ALTAIR-McGill-x-UVictoria/Altair-Photodiode-Readout/README.md

# Altair-Photodiode-Readout
Precision readout electronics for the integrating sphere photodiodes. Contains PCBs, RF shields, Carrier boards, and basic drive software.
