ALTAIR-McGill-x-UVictoria/Altair-Photodiode-Readout/Squad_V26.5a/Sergeant_SchematicV26.4a.pdf

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
Title

Size | Number | Revision
Tabloid
Date: | 5-27-2026 | Sheet of
File: | C:\Users\..\top.SchDoc | Drawn By: V26C (V26.4a)

VBAT

NEG_SW

PWR1
Power.SchDoc

VBAT

SPI_CS_BV
SPI_SCLK
SPI_MOSI
SPI_MISO
SPI_CS_ADC

ADC_CLK
ADC_DRDY
ADC_STRT
ADC_RESET

INT_HLD
INT_RST

INT_SLCT_A
INT_SLCT_B

IVC_SW_1
IVC_SW_2

BIO1
BoardInterfaces.SchDoc

A5VSW -11V

IVC_SW_IN

ACF_SWA_IN

TIA_OUT

SPI_SCLK
SPI_MOSI

SPI_CS_BV

BRD_TMP
PD_TMP

GUARD

GAIN_SW

IVC_SW

ACF_SW

TIA_SW

TIA1
TIA.SchDoc

ACF_IN_SGT

IVC_IN_SGT

GUARD

IVC_SW1
IVC_SW2

IVC_OUT

ACF_OUT

ACF_HOLD
ACF_RESET

ACF_SELB

ACF_SELA

INT1
Integrators.SchDoc

GUARD

PD_TMP

BRD_TMP

TIA_OUT

SPI_CS_ADC

STRT

ACF_OUT
IVC_OUT

SPI_MOSI

SPI_SCLK

SPI_MISO

DRDY

RESET

ADC_CLK

NEG_SW

GAIN_SW

IVC_SW

ACF_SW

TIA_SW

ADC1
ADC.SchDoc

3V3

1 6

### ALTAIR Photodiode Acquisition Payload - Sergeant

(Based on UVic ORCASat design Rev A.6 by Evan Moore)

4V9

10V

Nicholas Sandor

A2V5 AVDD

BIO1 contains most (but not all) interfaces between this board and others:
Main system header, power header, board-stacking headers, mounting holes. Most other sheets contain some other parts of the interface.

PWR1 turns the input power into the needed power nets: +10V, switch-specific +5V, ADC AVDD (its own +5V), -11V for the integrators, +4.9V virtual ground, +2.5V for the integrator output shifting and ADC reference.

TIA1 handles both ends of the photodiode (reverse bias setting and switching on the cathode, photocurrent on the anode).

It also contains a transimpedance amplifier for directly measuring the current in the case where the laser is not pulsed, a relay switch to change the gain on that TIA, and relay switches to instead send the photocurrent to the integrators for time-averaged photocurrent measurements.

It also contains temperature monitors for both the board (specifically near the TIA) and the photodiode mounting location.

We need to measure the
extremely small
photodiode current as
precisely as possible, so
the traces that carry it are very sensitive to noise
from many sources. To
help accomplish this,
those traces are
surrounded by guards,
shown in these schematics
as cyan wires and lines.

INT1 contains two integrator circuits.

One works with the ACF2101 dual-channel switched integrator, which is the primary measurement device for photocurrents from both the Sergeant board and the stacked Soldier board, connected through spring-loaded pogo pins and pads.

The other works with the IVC102 single-channel switched integrator, which serves to validate the values given by the ACF2101. The Soldier board has its own IVC102 as well.

ADC1 contains the analog-to-digital converter, some inverting amplifiers that scale down, shift, and negate the integrator outputs to a range the
ADC can read, and a clock generator circuit for externally clocking the ADC.

The A2V5 power net is taken from the ADC's internal voltage reference.

# THIS REVISION, V26_, WAS SENT FOR FABRICATION ON

____.

# Compatible board: Soldier: ______

Changes from V26B include:
- Added TIA isolation relays and associated control lines to prevent amplifier contention
- Add 2:4 Decoder to allow for one extra IO relay control and enforce amplifier mutual exclusivity
- Rework power-on sequencing to ensure that ADC AVDD is on before input voltages on its lines rise above allowable thresholds
- Add input anti-aliasing filters for all critical inputs (also provides over/undervoltage protection)
- Fix thermistors lacking any bias
- Updated soldier to bring it in-line with V26B baseline
- Various little fixes
- Fix fast-start for 10V
- 5V adjustment resistors removed (fixed voltage model)
- Drop TIA max voltage from 10V to 5V to prevent overvoltage events in case of negative photocurrent

D D

C C

B B

A A

Title

File: | C:\Users\..\BoardInterfaces.SchDoc | Drawn By:

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
440054-4

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
10 10
11 11
12 12
13 13
14 14
15 15
16 16
17 17
18 18
19 19
20 20

MP1 MP1
MP2 MP2
MP3 MP3
MP4 MP4
MP5 MP5

J1

DF19-20P-1V_52_

01 01
03 03
05 05
07 07
09 09
11 11
13 13
15 15
17 17
19 19

02 02
04 04
06 06
08 08
10 10
12 12
14 14
16 16
18 18
20 20

J2

CLP-110-02-X-D

01 01

03 03

05 05

07 07

09 09

11 11

13 13

15 15

17 17

19 19

02 02

04 04

06 06

08 08

10 10

12 12

14 14

16 16

18 18

20 20

J3

CLP-110-02-X-D

SYS_VBAT
SYS_GND
SYS_DVDD
DIG_GND

INT_SLCTA
SYS_RESET
INT_RST
INT_HLD
INT_SLCTB
DRDY1
DRDY2
SPI_MOSI
STRT1
STRT2
SPI_MISO
SPI_CS3
SPI_CS4
SPI_SCLK
SPI_CS1
SPI_CS2
IVC_SW_1_Sol
IVC_SW_2_Sol
IVC_SW_1
IVC_SW_2

GND

SYS_GND
DIG_GND
DRDY1
DRDY2
SPI_MOSI
STRT1
STRT2
SPI_CS3
SPI_CS4
SYS_GND

SYS_VBAT
SYS_RESET
SYS_DVDD
ADC_CLK
SPI_MISO
SPI_SCLK
SPI_CS1
SPI_CS2
IVC_SW_1_Sol
IVC_SW_2_Sol

SYS_GND

DIG_GND

DRDY2
DRDY1

SPI_MOSI

STRT2
STRT1

SPI_CS4
SPI_CS3
SYS_GND | IVC_SW_2_Sol IVC_SW_1_Sol SPI_CS2 SPI_CS1 SPI_SCLK SPI_MISO ADC_CLK SYS_DVDD SYS_RESET SYS_VBAT

VBAT
top[5B], Power[1B]

3V3

GND

INT_SLCT_B top[5B]

R2
47R

R1

10k

3V3

ADC_RESET | top[5B]
INT_RST | top[5B]
INT_HLD | top[5B]
ADC_DRDY | top[5B]

SPI_MOSI top[5B], ADC[5B], TIA[1D]

INT_SLCT_A | top[5B]
ADC_STRT | top[5B]

SPI_MISO top[5B], ADC[5B]

R4
0R OPT

R3
0R OPT

R7
TBD OPT

R6
TBD OPT
R10 | SPI_CS_BV | top[5B], TIA[1D]

TBD OPT

R9
TBD OPT

R5
47R

SPI_SCLK top[5B], ADC[5B], TIA[1D]

R11
47R
R13 | SPI_CS_ADC top[5B], ADC[5B]

TBD OPT

R12
TBD OPT

IVC_SW_1 top[5B]
IVC_SW_2 top[5B]

ADC_CLK
top[5B], ADC[5B]
H1 H2 H3 H4

GND

R8

0R DNP

GND

2 6

### ALTAIR Photodiode Acquisition Payload - Sergeant

R99

0R
GND

Nicholas Sandor ² ¹ D4

SMAJ12A

GND

1 | 2 | VBAT

F1

0ZCG0030FF2C

JP Power Header,
4x1 THT Partially Shrouded

J2 : Top Board-Stacking Header; 10x2 SMD (female)

Placed and aligned directly above

J3 : Bottom Board-Stacking Header; 10x2 SMD (female)

In practice the top header exists primarily to facilitate debugging and the bottom header connects to a male FTSH-110-F-DV header on the Soldier board.

Previously, the Specialist board was also part of the stack, but the tall relays make this impractical.

J1 : System header; 20x1 Vertical SMD

Populate only ONE of R3 (!DRDY1) or R4 (!DRDY2). Channel numbers must match.

Populate only ONE of R6 (STRT1) or R7 (STRT2).
Exception: Can populate both if simultaneous non-SPI external triggering is desired. Channel numbers must match.
Can use nonzero resistance for damping the signal as desired.

Populate R8 if configuring ADC conversion through SPI commands instead.

Populate only ONE of R9 (!CS3) or R10 (!CS4).
Channel numbers must match.
Can use nonzero resistance for damping the signal as desired.

Populate only ONE of R12 (!CS1) or R13 (!CS2). Channel numbers must match.
Can use nonzero resistance for damping the signal as desired.

Board Mounting Holes (M3)

Digital ground used to only connect to analog ground after passing through a pin of the IVC102 integrator, to shield the sensitive side of the chip from digital noise. That shielding is now done with the virtual ground net, and R99 connects digital ground to analog ground close to the power header.

F1 polyfuse and D4 TVS diode protect the board from incorrect power supply characteristics or connections.

Rated for up to 14V and 300mA.

D D

C C

B B

A A

Title

File: | C:\Users\..\Power.SchDoc | Drawn By:

IN 1
IN 2
IN 3
EN/UV 4
PG 5
ILIM 6
PGFB | 7
SET | 8
GND | 9
OUTS | 10
OUT | 11
OUT | 12 GND 13

U3

LT3045

EN/UV 3

ILIM 6

IN 1
IN 2
IN 13

PG 4

VIOC 7

GND | 9
OUT | 12
OUT | 11
OUTS | 10
PGFB | 5
SET | 8

U8

LT3094EDD#PBF

VIN 1

EN 3

VOUT | 5
GND | 2
SENSE/ADJ | 4

U4

ADP7142AUJZ-5.0-R7

VBAT

top[5C], BoardInterfaces[3A]

R14
0R

GND

GND | GND

C3
10uF

R15
100k

GND

C2
10uF

C1
10uF

GND

R17
10k

R16
300k

GND

C4
10uF

GND

R18
680R

D2
BLUE

GND

10V

SW | 1
NFB | 3
SHDN 4
GND 2

VIN 5

U7

LM2611AMF/NOPB

C14
10uF

GND

L1

10uH

C15

1uF

R29
30k

C16
330pF 2 1
D1
MBR0520
GND | GND

L2

10uH

C18
10uF

GND

GND

C19
10uF

GND

R30
1k

-16V

R31
1.5k

C17
1uF DNP

GND

TP1

-16V

R32
110k

C21
4.7uF

GND GND

C20
10uF

GND

TP5 -11V

GND

TP2

GND
C9
1uF
TP3

C10
0.1uF

A5VSW

R21 10k

R22
10k

3 6

### ALTAIR Photodiode Acquisition Payload - Sergeant

TP4

R23

2.32k R24 2.23k

4V9

C11
0.1uF

C12
10uF

C13
0.1uF

1
2

JLED

OUT A 1
-IN A 2
+IN A 3
V- 4 | +IN B 5

-IN B 6

OUT B 7

V+ 8

U5

OPA2182

GND | GND

10V

10V

GND

C1 1

C2 3 B¹

## 2 B2

5

E2 4

E1 6

U6
ZXTC2045E6

GND

10V

R25 47R

R26 47R

R28 0.1R

R27 0.1R

GND

10V

GND

C58
2.2uF

GND

C59
2.2uF

R34
100k

R19

47R

GND

C5
0.1uF | C24
| 0.1uF

C6
10uF | C8
| 10uF

DNC 1

VIN 2

TEMP 3
GND 4
TRIM/NR | 5
VOUT | 6
NC | 7
DNC | 8

U10

REF5025

C7
10uF
GND | GND
10V | A2V5 TP10

R35
100k

R20

47R

NEG_SW

top[5C], ADC[4B]

GND

AVDD

+10.0V, up to 500mA (or lower current limit if set)

U3 SET pin sets output voltage:
V = R15 * (100uA)

Larger capacitance in parallel reduces output ripple level.

If different board voltage level is desired, adjust value of R15 as necessary according to the above equation.

For 500mA current limit: Use 0-Ohm jumper for R14 .

Otherwise, current limit is
I(lim) = (150 mA-kOhm) / R

Decide on a current and set R14 to the found value of R.

U3 PGFB pin:
Power Good functionality is not used (see No-ERC on PG).

The R16 R17 divider is for fast start-up functionality, to speed up the regulator's transient response despite C3 on the SET pin otherwise slowing it down.

As long as the output voltage is lower than the set threshold, there is 2mA instead of 100uA through SET pin. That threshold is
V(PG) = (0.3V)(1 + R16/R17) - I(PGFB) R56

Where I(PGFB) is on the order of 1E-8 A.

1.4MHz Cuk converter to generate a negative supply. Consider soft start?

Negative voltage regulator set to -11V for the integrators.

(Current needed from this net is on the order of 20mA, far below the 500mA limit of the regulator.)

AVDD pin of ADC requires
significant decoupling capacitance to supply current during sampling process.

5V ±1%, 200mA supply for ADC AVDD.

Gain switches (and digital isolators for virtually grounded component controls) are powered from a separate 5V reference, to keep noisy transients from switching the relays off of the sensitive rails.

The switches' 5V rail does not need to be very precise, and we want to remove dependency on ADC AVDD to keep that line more flexible.

This is a very simple divider using 0603 resistors that will get us close enough to 5V, or 1/2 of 10V.

The divider itself will dissipate about 5mW. If this is too much the resistances can be increased to some extent.

Steady state is when V(NFB) = -1.23V. Thus output voltage is
Vout = (-1.23V)(1 + R29/(R30 + R31))

This is the source of the virtual ground used by the bias control circuit, TIA, and integrators. It is specified as 4.9V to prevent a leakage current at the TIA input from saturating the ADC.

More accurately, the target voltage is 10V(2.23/(2.23+2.32)) = 4.9010989V +/- 0.2% (approx. tolerance)

U6 OPA2182 is a 2-channel, zero-drift op-amp used to buffer the relay supply voltage and the virtual ground. It can source or sink up to 65mA, but it may exhibit ringing or unstable transient responses with a load capacitance of up to 1nF.

Since the OPA(2)182 is a zero-drift op-amp, it has an internal switching mechanism that runs at about 200kHz. While this is usually strongly attenuated, the emitter-follower may amplify it somewhat. However, 200kHz is far outside the bandwidth at which the ADC can perform measurements even on its fastest sample rate.

The virtual ground has some fairly steep requirements that we must meet. Any noise in the virtual ground couples directly into TIA readings and every stage of the integration process for the integrators, so the node must be low-noise. It must also be able to sink significant current from the power-hungry integrators, and it must support significant load capacitance from bypass capacitors on digital isolators, bias control ICs, and intgrators.

To address this, a complementary emitter-follower output stage is added to the OPA182 output to source and sink current and to isolate the capacitance from the op-amp's output drive.

Most simpler solutions are either too noisy, too unstable with capacitances above a few picofarads, or have too little current capacity.

Power draw from R23/R24 divider:

P = V^2/R = 100/4550 = 21mW.

Quite high. Self heating concern?

Note that you cannot go TOO high on these resistors, or the VGN will take too long to rise, risking all 5V components referenced to it.

AVDD is now first to power on, to prevent power supply sequencing issues from overvolting the ADC inputs on startup. We use AVDD as the enable for the 10V line. Adjustment resistors were removed as this is the fixed voltage model so adjustment is not possible in any case.

Input/output capacitors are now reccomended 2.2uF.

Fast start up was still set to 6.3V, vestige from when this was a 7.5V supply probably. But as a result this takes multiple seconds to reach 10V.

Switching R16 to 300k gives a fast start threshold of 9.3V, which is better.

The negative voltage is
disabled by default. It should not be enabled until the ADC has powered up and confirmed that 2.5V exists across
REFP0/REFN0.

(e.g., enable and check
FL_REF_L1, then use the
external reference to measure (AVDD-AVSS)/4 as approx.
0x400000)

2.5V ±0.05%, 20mA supply for ADC reference and LT1991 common-mode voltage.

V26A tried to use the ADC's internal 2.5V reference instead of this part. That does not work because the internal reference is disabled by default, and if it is not enabled before the negative voltage is, the ADC sees dangerously negative voltages on analog inputs.

D D

C C

B B

A A

Title

File: | C:\Users\..\TIA.SchDoc | Drawn By:

4

K5
118-A-5/2D

1

2

3

### 4 K6

118-A-5/2D

1
2
3
4

K1
118-A-5/2D

1

2

3

### 4 K2

118-A-5/2D

1
2
3
4

K3
118-A-5/2D

1

2

3

### 4 K4

118-A-5/2D

A5VSW

ACF_SWA_IN

top[3C]

J10

1 2 3 Q1

GND

R37
100k

R36

47R

ACF_SW

top[4C], ADC[3B]

J11

1 2 3 Q2

GND

R40
100k

R39

47R

IVC_SW

top[4C], ADC[3B]

A5VSW

IVC_SW_IN

top[3C]

GUARD ACF INTEGRATOR INPUT

GUARD IVC INTEGRATOR INPUT

J12

1 2 3 Q3

GND

R43
100k

R42

47R

GAIN_SW
top[4C], ADC[4B]

A5VSW

C31
300pF

R46

10k

IN+ 1

GRD_1 2
DNC 3
V- 4

IN- 8
GRD_2 7
OUT 6

V+ 5

U13

OPA928DR

R45
1Meg

C30
10pF

(Same guard net)

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
60312002114503

1
2
3
4
5 6

J6
USB-miniB K

A

C28
1uF

C29
0.1uF

GND

TIA_OUT

top[3C], ADC[2B]

GND

10V

C22
0.1uF

C23
10uF

TP6

SPI_SCLK

top[4C], ADC[5B], BoardInterfaces[4B]

SPI_MOSI

top[4C], ADC[5B], BoardInterfaces[4B]

SPI_CS_BV

top[4C], BoardInterfaces[4B]

PD_K
PD_A

GUARD

GND

D

1

SA 2
GND | 3
VDD | 4
NC | 5

IN 6

VSS 7

SB 8

U11

ADG1419BRMZ-REEL7

C25
1uF

C00
TBD OPT

C0
TBD OPT

R0
TBD

10V

J5

R33
100k

TP7

NT 10K

RT1 C32
0.1uF

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
BC020-03-A-0200-0300-L-G

R49

0R OPT
R50
0R OPT

BRD_TMP
top[3C], ADC[4B]

R47

0R OPT

R48
0R OPT

PD_TMP
top[3C], ADC[4B]

TMP_COM
TMP_COM

# TEMPERATURE MONITORING

# PHOTODIODE INPUT/OUTPUT

# OPTIONAL RC FILTER

# BIAS SWITCHING

# BIAS VOLTAGE CONFIGURATION

# AMPLIFIER SWITCHING

# GAIN SWITCHING

# TRANSIMPEDANCE AMPLIFIER

GUARD top[3C], Integrators[4B]

10V

VBIAS

SYNC 1
SCLK 2
DIN 3

VOUT 6
GND 5

AVDD 4

U9

DAC5311

1 2

D3

MMSZ4679 DNP

4 6

### ALTAIR Photodiode Acquisition Payload - Sergeant

4V9

4V9

4V9

4V9

4V9

10V

GND | 4V9

4V9

4V9

4V9

4V9

A5VSW

VCC1 1

GND1 8

INA 2
INB 3
INC 4
IND 5
INE 6
INF 7
VCC2 | 16
GND2 | 9
OUTF | 10
OUTE | 11
OUTD | 12
OUTC | 13
OUTB | 14
OUTA | 15

U12

ISO7760DBQR

C27
0.1uF

C26
0.1uF
GND | 4V9

# DIGITAL SIGNAL ISOLATION

J15

1 2 3 Q4

GND

R41
100k

R38

47R

1
2
3
4

K7
118-A-5/2D

1

2

3

### 4 K8

118-A-5/2D

A5VSW

TIA_SW

top[4C], ADC[3B]

R51
10k

R44
10k

AVDD

AVDD

AVDD

The relays are paired and
wired in series (such that the
switch terminals are all Pin 3)
for extremely low EMF

Pickering 118-A-5/2D reed relays are used for much lower leakage current than solid-state switches while taking very little board space for relays.

Relay coil resistance (i.e., between A5VSW and MOSFET drains) is 2.2k per relay (1.1k per pair).

K1 and K2 allow photocurrent to reach the sergeant channel of the ACF integrator, which can give time-averaged photocurrent measurements for both the sergeant and the soldier photodiodes with nearly identical characteristics between the two.

K3 and K4 allow
photocurrent to reach the
IVC integrator, which
serves to validate the value read from the sergeant
channel of the ACF.

K5 and K6 add an impedance in parallel to R45 and C30 to lower the gain of the TIA, which measures the photocurrent in the case where the laser is not being pulsed.

NOTE: Feedback resistors must have EXTREMELY low thermal drift.

Capacitors should have C0G/NP0 rating.

Selected CF values are optimized for maximum stable bandwidth with the OPA928 (GBW=2.5MHz) driving the high input capacitance of the photodiode.

Here, we expect the anode to be at 4.9V and the cathode to be somewhere between 4.9V and the maximum reverse-bias voltage.

Place caps as close to the V+ terminal of the amp as possible

DAC U9 sets SPI-controlled bias voltage for photodiode reverse-bias operation. Nominal 2.5V output. Current limit 10mA.

AD5601 is a drop-in replacement for DAC5311 with slightly worse noise and linearity but identical pinout and interface. DAC5311 is preferred if available.

If used, place RC
filter as close as
possible to the
photodiode anode.

Otherwise, DNP the
capacitors and set
R0 = 0 Ohms.

Analog signals are limited to VDD + 0.3V, so VDD
must be at least higher
than the maximum reverse
bias generator output.

When J5 is jumped, the reverse bias generated from U9 is disabled. The same effect can be achieved by writing 0b01 to the most significant bits of the DAC5311's SPI shift register to set it in 1k power-down mode.

Calculation for the TIA stability capacitor:

Feedback resistor value: R [Ohms] (Calculated above) Bandwidth of circuit: f [Hz]

C = 1/(2pi R f) [F]

Board Temp Monitor
- Placed near TIA

Thermistor Local/Remote
Acquisition Jumpers:
Populate only one jumper in each of the indicated pairs to use on-board or off-board
ADC (not both).

The TIA is powered in
single-supply mode. This
complicates the use of the integrators.

In short, the TIA and the
integrators must be at or near the same common-mode voltage.
Furthermore, the integrators internally connect their
common-mode voltage to what they perceive as ground. Previous revisions violated that by having the TIA at 4.9V and the
integrators at 0V. Now, the integrators are moved up to treat 4.9V as a virtual ground.

This is expected to have
significantly less noise in the TIA signal compared to a dual-supply TIA.

D3 Photodiode protection Zener diode. Should only be placed if software cannot be trusted to operate the DAC safely. In that case, it should be populated with a Zener that will break down before the photodiode does, and paired with a current-limiting resistance in the RC filter. Most Zeners will have microamp scale leakage current. This acts as an additional source of shot noise that adds together with that from the photodiode dark current and limits measurement precision.

Per the AD5601 datasheet,
C23 should be a tantalum
capacitor. It is currently specified as an MLCC.

Removed the bias voltage output to the ADC. Measuring the bias voltage would require an additional step to scale it down or subtract virtual ground from it and avoid damaging the ADC, as it can go up to 10V.

U12 is a 6-channel digital isolator. This is necessary to propagate
the DAC SPI and bias switch control to the virtual-ground components.

The A5VSW should arguably be DVDD, since 3.3V is a bit under 0.7*5V and is thus slightly out of spec.

A 6-channel isolator is necessary for the integrator controls, so a second one is used here with 2 unused channels instead of using a 4-channel variant. The 4-channel isolators are typically no smaller than 6-channel isolators.

This IC is vestigial at this point. We no longer control bias with an IO

Added new relay pair for TIA isolation, and reduced the positive rail on the TIA to make it impossible for it to overvolt the ADC

These thermistors were missing a bias source so wouldn't output anything. We use the nice, clean AVDD for this now.

D D

C C

B B

A A

Title

File: | C:\Users\..\Integrators.SchDoc | Drawn By:

SW IN B 1
IN B 2
CAP B 3

COM B 4
GND B 5
OUT B 6

SW OUT B 7
SW COM B 8

SELECT B 9
RESET B 10
HOLD B 11
V- 12 | V+ | 13
| HOLD A | 14
RESET A | 15
SELECT A | 16
SW COM A | 17
SW OUT A | 18
OUT A | 19
GND A | 20
COM A | 21
CAP A | 22
IN A | 23
SW IN A | 24

U14

ACF2101BU

AGND 1 | GND 13

IN 2

-IN 3

C1 4

C2 5

C3 6

-VCC 9

VO | 10 S¹ 11 | S² 12

+VCC 14

NC1 7
NC2 8

+

60pF

C₁

C₂ 30pF

C₃

10pF

S₁

S₂

U15

IVC102/SO

R52

TBD DNP

R53

CAP DNP

R55

TBD DNP

R56

CAP DNP

CAPB | CAPA

ACF_IN_SGT

top[4B]
SIGNAL | 1
GUARD_1 | 2
GUARD_2 | 2

(3)

J9

Pogo_Pad

GUARD

top[4B], TIA[4C]

R60 0R OPT

R59 0R OPT

R58 0R OPT

IVC_IN_SGT

top[4B]

R61
0R

top[4B] IVC_SW1
top[4B] IVC_SW2

C39
0.1uF

C40
10uF

C35
0.1uF

C36
10uF

C33
0.1uF

C34
10uF

-11V

-11V

10V

top[4B] ACF_HOLD

top[4B] ACF_RESET

top[4B] ACF_SELB

top[4B] ACF_SELA

R57
0R

R54
0R

FUNCTION HOLD SWITCH RESET SWITCH
INTEGRATE | CLOSED | OPEN
HOLD | OPEN | OPEN
RESET | OPEN | CLOSED

OPERATING THE ACF2101
FUNCTION | SWITCH 1 | SWITCH 2
INTEGRATE | CLOSED | OPEN
HOLD | OPEN | OPEN
RESET | OPEN | CLOSED

OPERATING THE IVC102

1

J8
807-22-001-10-006101
IVC_OUT | top[3B], ADC[1C]

C37
0.1uF

C38
10uF

10V

ACF_OUT | top[3B], ADC[1B]

SOLDIER_GUARD

5 6

### ALTAIR Photodiode Acquisition Payload - Sergeant

4V9

4V9

4V9

4V9

4V9
VCC1 1

GND1 8

INA 2
INB 3
INC 4
IND 5
INE 6
INF 7
VCC2 | 16
GND2 | 9
OUTF | 10
OUTE | 11
OUTD | 12
OUTC | 13
OUTB | 14
OUTA | 15

U16

ISO7760DBQR

C41
0.1uF

C42
0.1uF
A5VSW | 10V
GND | 4V9
GND | 4V9
4V9 | 4V9
4V9 | 4V9
4V9 | 4V9

Switches are TTL/CMOS compatible. Switch Open: Logic HIGH (3.3V or 5.0V) Switch Closed: Logic LOW (0V)

Sergeant has a pogo pin connector ( J8 ) to Soldier's pads for the output of the ACF integrator.

Soldier has 3 1x2 pogo pin connectors to Sergeant's pads ( J9 ) for the input and guard on its side of the ACF integrator.

R54 R57 R61
These jumpers exist to control where the SW COM pins connect to ground. The routing of the wires on the schematic reflects the desired routing of the traces on the PCB, where those nets should be routed between the two boards' guards to minimize crosstalk between them.

R52 R55 R53 R56
These are nominally DNP. They exist to provide points where we can add capacitors (typically not resistors) to adjust the integrator responses as desired after the board is already fabricated.

However, in doing so, great care must be taken to choose matching pairs of passive components to keep the two sides of the integrator as close as possible in response.

R60 R59 R58

These can be jumpers or capacitors used to fine tune the IVC's response. At least one must be populated to close the op-amp feedback loop.

IVC102 wants to run with +/-15V relative to what it thinks is ground. Generating 19.9V would require a second noisy switching power supply in addition to the Cuk converter, but 10V is within the minimum specification for the positive supply.

U16 is a 6-channel digital isolator. This is necessary to propagate the integrator switch controls to the virtual-ground integrators.

The A5VSW should arguably be DVDD, since 3.3V is a bit under 0.7*5V and is thus slightly out of spec.

A previous board revision connected ACF COM and SW-COM pins and IVC AGND pin to the respective guards. This was undone on the board because it caused a short circuit. It is now recognized that this was likely because the guard was pulled to 4.9V by the TIA. These are not re-connected here, but it is something to consider restoring with this design.

D D

C C

B B

A A

Title

File: | C:\Users\..\ADC.SchDoc | Drawn By:

P1 1
P3 2
P9 3
VEE | 4
REF 5 | OUT | 6

VCC 7

| M9 | 8
| M3 | 9
| M1 | 10

U17

LT1991AIMS

P1 1
P3 2
P9 3
VEE | 4
REF 5 | OUT | 6

VCC 7

| M9 | 8
| M3 | 9
| M1 | 10

U18

LT1991AIMS

1
2

JTIA

1
2

JACF

1
2

JIVC

1 2

J13

MMCX

GND

AINCOM 1

AIN5 2
AIN4 3
AIN3 4
AIN2 5
AIN1 6
AIN0 7
STR/SYNC | 8
CS | 9
DIN | 10
SCLK | 11
DOUT/DRDY | 12
DRDY | 13
DGND | 14
IOVDD | 15
DVDD | 16
CLK | 17
RESET | 18

AIN11/GPIO3 19
AIN10/GPIO2 20
AIN9/GPIO1 21
AIN8/GPIO0 22
REFOUT | 23
REFCOM | 24
NC | 25

AVDD 26

AVSS | 27
AVSS-SW | 28 REFN0 29

REFP0 30

AIN7/REFN1 31
AIN6/REFP1 32

U2

ADS124S08IPBSR

C52
10uF

C51
0.1uF
GND
top[1C], TIA[4A] GAIN_SW

top[2C], TIA[3D] PD_TMP
top[2C], TIA[3D] BRD_TMP
GND | GND
TP8 | C55
| 10uF TP9

top[2C], TIA[6A] TIA_OUT

Photocurrent - TIA
Photocurrent - ACF
Photocurrent - IVC
4.9V
SPI_CS_ADC | top[2B], BoardInterfaces[4B]
STRT | top[2B]
SPI_MOSI | top[2B], BoardInterfaces[4B], TIA[1D]
SPI_SCLK | top[2B], BoardInterfaces[4B], TIA[1D]
SPI_MISO | top[2B], BoardInterfaces[4B]

R65 47R

R64 47R

DRDY | top[2B]

RESET

top[2B]

GND

3V3

C53
0.1uF

C54
10uF

top[2B], Integrators[3B] ACF_OUT

10V

C43
0.1uF

C44
10uF

GND

-11V

C45
0.1uF

C46
10uF

GND

top[2B], Integrators[5B] IVC_OUT

GND

C47
0.1uF

C48
10uF

10V

GND

C49
0.1uF

C50
10uF

-11V

VDD 4

OE 1

OUT | 3
GND | 2

Y1

SIT1602Bx

3V3

R66
10k

C56
0.1uF

GND

VDD 6

1G 2

CLKIN 1

NC | 7
Y0 | 3
Y1 | 8
Y2 | 5
GND | 4

U1

LMK1C1103PWR

GND

R67
10k

C57
0.1uF

3V3

GND

R68 | 33R
R69 | 33R
R70 | 33R

GND

B, C (entire region)

top[2B], BoardInterfaces[3C] ADC_CLK

R71

0R A, C

R72

0R A, B

1 2

3
4

5

J14
66012002111503

GND
GND

6 6

### ALTAIR Photodiode Acquisition Payload - Sergeant

A2V5

GND

A2V5

A2V5

R62

5.11k

R63

5.11k

R73

2k | C61 2nF

GND R74

2k | C62 2nF

R75 GND

2k | C63 2nF

GND R76

2k | C64 2nF
| GND

# Input Antialiasing Filters

4V9

Doubles as input protection

top[1C], TIA[5C] ACF_SW
top[1C], TIA[5B] TIA_SW

top[1C], TIA[5C] IVC_SW

A

1

B

2

Y3 3

GND 4

Y2 5
Y1 6
Y0 7

VCC 8

U19

SN74LVC1G139DCTT

top[1C], Power[1A] NEG_SW

C60
0.1uF

GND
GND

AVDD

Additional MMCX connector can be used for direct low-noise measurement of the TIA output or one of the integrator outputs.

The ADC clock can be on the Sergeant, Soldier, or Specialist boards, and exactly one is required across all three boards.

To have the clock on the Sergeant board, DNP components labelled with A.

To have the clock on the Soldier board, DNP components labelled with B.

To have the clock on the Specialist board, DNP components labelled with C.

In every case, populate every other component within the red border.

Compatible SiT1602B oscillator variants:

SiT1602B[C|I][T|-]2[1|2|3][33|XX|YY][E|S|N]4.096000

It seems very useful to be able to measure the nominal 4.9V line, since the all the front-end outputs depend on what exactly is on that line. Since the bias voltage cannot be easily measured, that frees up a channel to do so.

ADC can be configured to use any two inputs as the differential pair for signal measurement (including AINCOM).

ADC can be configured to set A8 - A11 as GPIO. These are used to control the Bias and gain switches for the TIA channels.

AVDD powers the PGA buffer. This requires a 5V rail for our spec to operate correctly. (Max 5.5V)

When PGA is bypassed (i.e. in single-ended measurement) the aboslute voltage restrictions on the input are (AVSS - 0.15V) < VIN < (AVDD + 0.15V).

Since the measurement is still a differential one, in order to have access to all possible byte codes (both positive and negative), a differential measurement should be made between the TIA input signal and 2.5V. Therefore when the TIA outputs 5V, the ADC measures a differential signal of 2.5V. And when the TIA outputs 0V (or close to), the ADC measures -2.5V.

-> Tie CS pin to DGND if CS is not used
-> Tie the CLK pin to DGND if the internal oscillator is used -> Tie the START/SYNC pin to DGND to control conversions by commands
-> Tie the RESET pin to IOVDD if the RESET pin is not used
-> If the DRDY output is not used, leave the DRDY pin unconnected or tie the DRDY pin to IOVDD using a weak pullup resistor

The integrator output varies from 4.9V (no charge) to nominally -10.1V (full scale). (It can go lower without saturating but this preserves the range from previous designs.) This design with the LT1991 has the transfer function
Vo = 1.25V (1 + Rf/150k) - Vi (Rf/150k),
where Rf = 450k || (50k+5.11k) = 45.08k.
The transfer function can more aggressively approach the bounds of the ADC full-scale range by changing the additional resistor (no more than 6.25k) between pins 6 and 8 (OUT and M9).

Compatible LT1991 variants: LT1991(A)(C|I|H)MS(#packaging code)

LT1991A has tighter tolerances in places that would be caught by calibration anyways, so it just makes calibration a little easier.

C/I/H indicates temperature range. C is 0 to 70C, I is -40 to 85C, H is -40 to 125C. Analog Devices does not currently make an LT1991AH.

Concerns with these:
Capacitive loading on the amplifier outputs?
- This shouldn't be an issue as the decently large R value should decouple the capacitance from the amp outputs
Offset error?
- Differential input impedance of this ADC is 1G, so the effective divider formed here only has a 2ppm offset which is already in the noise floor.

In any case, if these are causing problems adjusting the values or bypassing is easy.

Antialiasing filter Calculation:
Theoretical maximum over/underbias: +-5V Input current limit in conduction: 10mA -> 5 for safety

1000 ohm minimum

Datasheet reccomends single stage RC with cutoff ~10x ODR. Max ODR is 4k SPS, So cutoff freq is 40kHz.

2Kohm/2nF filter provides 39.7kHz cutoff.

Decoder for IO
expansion and to
enforce mutual
exclusivity on
switches
