ALTAIR-McGill-x-UVictoria/Altair-Photodiode-Readout/Enclosures/TestCover.stl

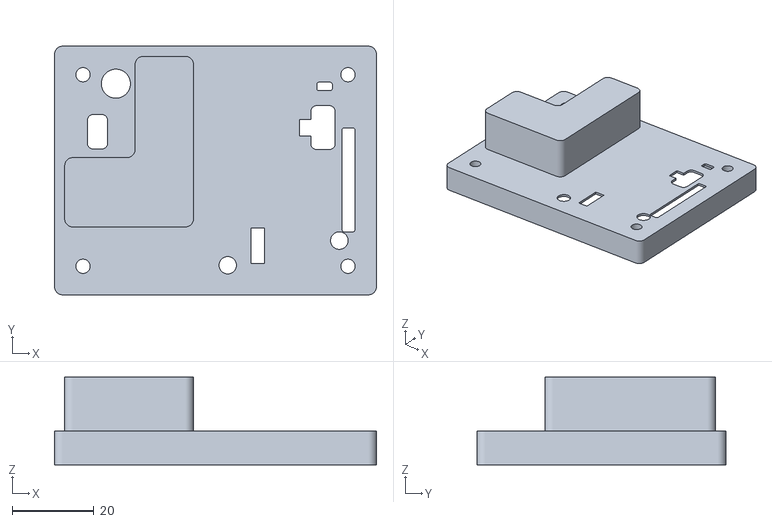
[picture p1: CAD file, 2026-07-20]
Enclosures/TestCover.stl
79.0 x 61.0 x 21.6
