ALTAIR-McGill-x-UVictoria/Altair-Photodiode-Readout/Squad_V26.5a/ALTAIR_PD_Squad_V26.5a.step

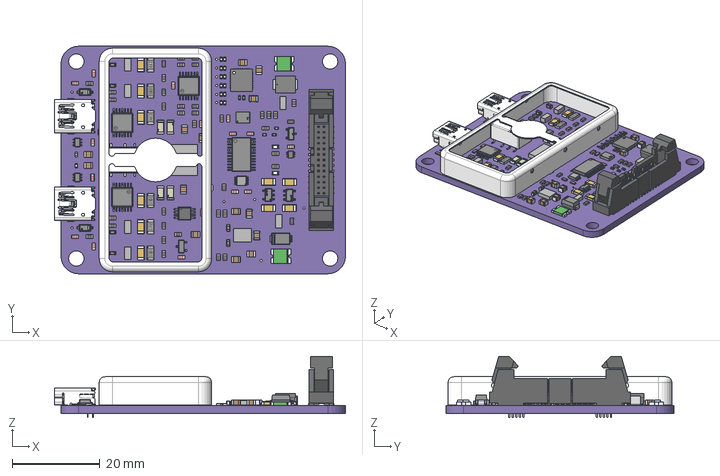
[picture p2: CAD file, 2026-10-29]
Squad_V26.5a/ALTAIR_PD_Squad_V26.5a.step
66.5 x 52.0 x 14.0 mm
