ALTAIR-McGill-x-UVictoria/Altair-Photodiode-Readout/Enclosures/Skirt.stl

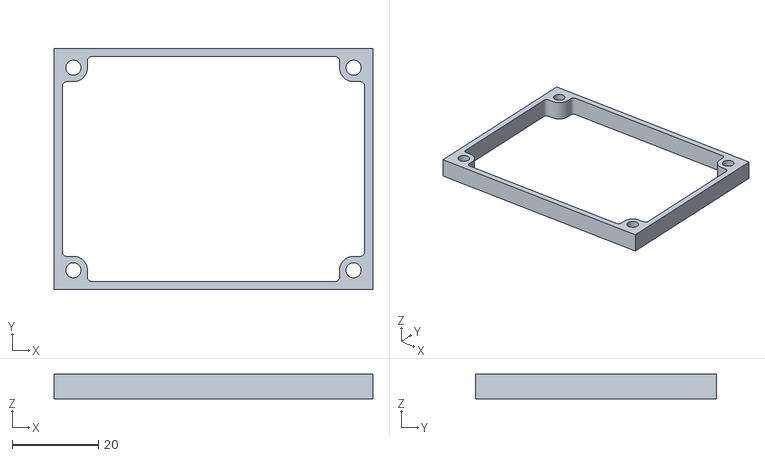
[picture p3: CAD file, 2026-07-20]
Enclosures/Skirt.stl
74.0 x 56.0 x 5.70
