ALTAIR-McGill-x-UVictoria/Altair-Photodiode-Readout/Enclosures/V26C_Enclosures.3mf

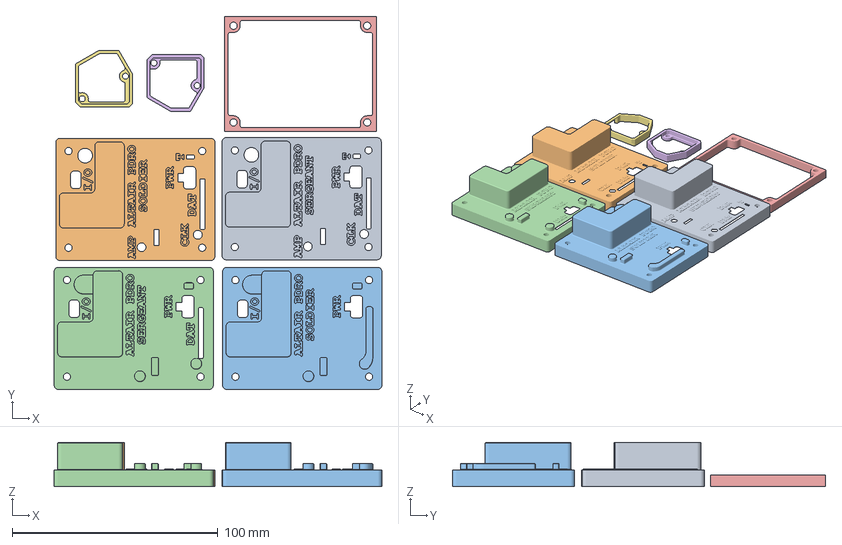
[picture p4: CAD file, 2026-07-20]
Enclosures/V26C_Enclosures.3mf
159.3 x 181.4 x 21.4 mm
Printed Cover - Open - Part 1.stl x 4
Skirt - Part 1(1).stl
10026V2-LH.stl
10026V2-RH -.stl
