ALTAIR-McGill-x-UVictoria/Altair-Photodiode-Readout/Enclosures/FlightCover - Soldier.stl

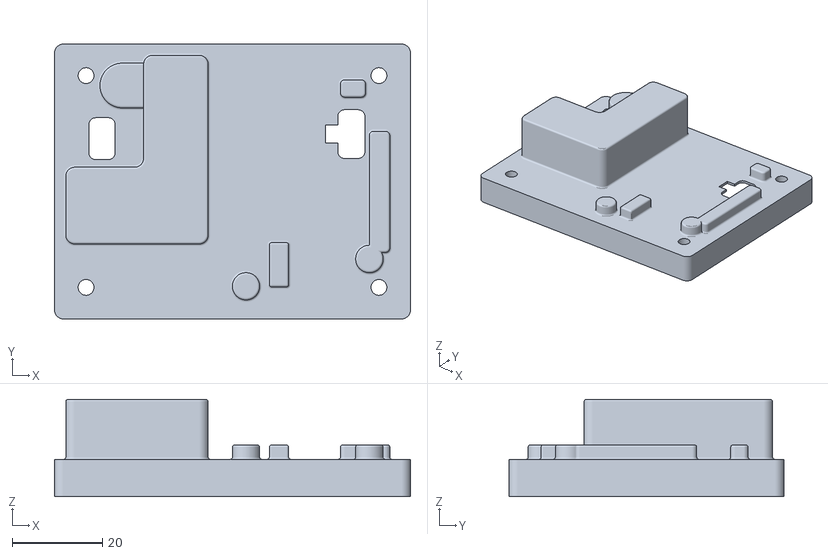
[picture p5: CAD file, 2026-07-20]
Enclosures/FlightCover - Soldier.stl
79.0 x 61.0 x 21.6
