ALTAIR-McGill-x-UVictoria/Altair-Photodiode-Readout/(list of files, cad)

Other CAD files:
Enclosures/FlightCover - Sergeant.stl
