ALTAIR-McGill-x-UVictoria/Altair-Photodiode-Readout/Squad_V26.5a/Sergeant_LayoutV26.4b.pdf

11

22

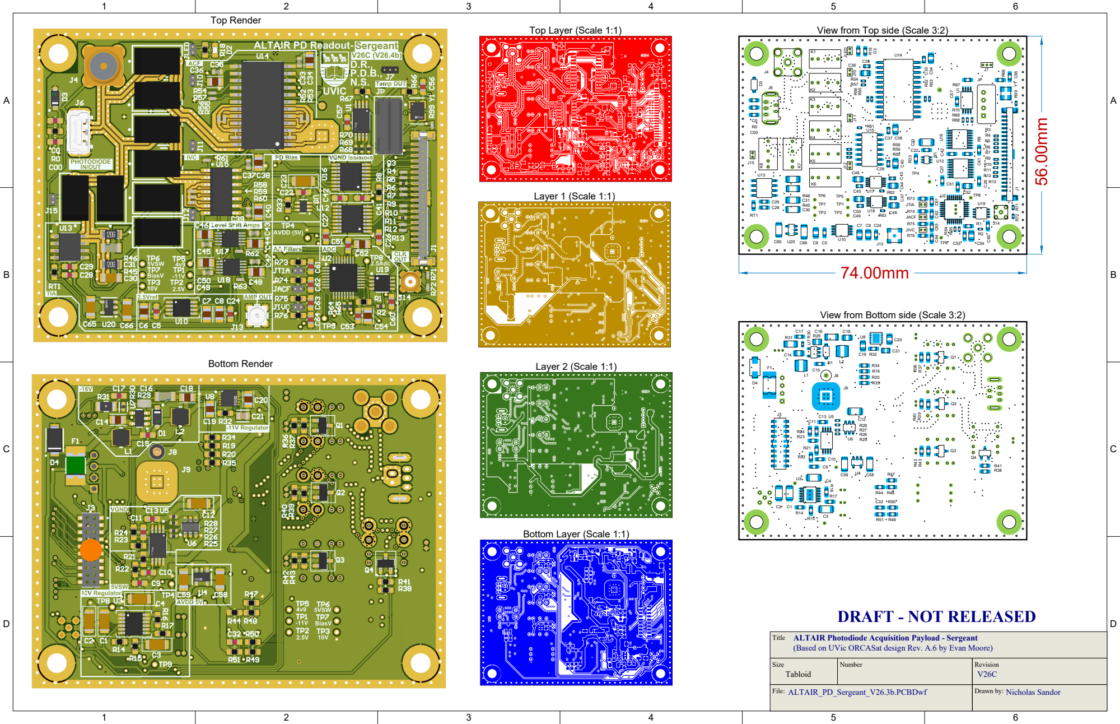
[picture p6: page 1]

View from Top side (Scale 3:2)

View from Bottom side (Scale 3:2)

ALTAIR Photodiode Acquisition Payload - Sergeant
Title
(Based on UVic ORCASat design Rev. A.6 by Evan Moore)
