ALTAIR-McGill-x-UVictoria/Altair-Photodiode-Readout/(list of files, drawings)

Other design files:
Sergeant_V26.4c/ADC_Sergeant.SchDoc
Sergeant_V26.4c/ALTAIR_PD_Sergeant_V26.4c.PcbDoc
Sergeant_V26.4c/Integrators_Sergeant.SchDoc
Sergeant_V26.4c/Power_Sergeant.SchDoc
Sergeant_V26.4c/Sergeant.PrjPcb
Sergeant_V26.4c/TIA_Sergeant.SchDoc
Sergeant_V26.4c/top_Sergeant.SchDoc
Soldier_V26.4c/ADC_Soldier.SchDoc
Soldier_V26.4c/ALTAIR_PD_Soldier_V26.4c.PcbDoc
Soldier_V26.4c/BoardInterfaces_Soldier.SchDoc
Soldier_V26.4c/Integrators_Soldier.SchDoc
Soldier_V26.4c/Power_Soldier.SchDoc
Soldier_V26.4c/Soldier.PrjPcb
Soldier_V26.4c/TIA_Soldier.SchDoc
Soldier_V26.4c/top_Soldier.SchDoc
Squad_V26.5a/ADC.SchDoc
Squad_V26.5a/ALTAIR_PD_Sergeant_V26.2b_Reference.PcbDoc
Squad_V26.5a/ALTAIR_PD_Squad_V26.5a.PcbDoc
Squad_V26.5a/BIAS_IO.SchDoc
Squad_V26.5a/DDC.SchDoc
Squad_V26.5a/DDC_INTEGRATOR.SchDoc
Squad_V26.5a/IO_Pwr_Clock.SchDoc
Squad_V26.5a/Power.SchDoc
Squad_V26.5a/RFSHIELDS.PcbLib
Squad_V26.5a/Squad.PrjPcb
Squad_V26.5a/TIA_SWITCHES.SchDoc
Squad_V26.5a/top_Squad.SchDoc
Test_Boards/DDC112_Breakout/DDC112_Breadboard.SchDoc
Test_Boards/DDC112_Breakout/DDC112_Prototypes.PrjPcb
Test_Boards/DDC112_Breakout/DDC112_TestBoard_v26.1b.PcbDoc
Test_Boards/DDC112_Breakout/TestBoard_v26.1b.SchDoc
