ALTAIR-McGill-x-UVictoria/Altair-Photodiode-Readout/(commit log)

2026-05-19 Sync Sergeant, Soldier, DDCtest
    Initial commit of the most recent sergeant (V26B) and soldier (V26A) boards, as well as the DDC test boards.
    [ADC.SchDoc, BoardInterfaces.SchDoc, DDC112_Breadboard.SchDoc, DDC112_Prototypes.PrjPcb, DDC112_TestBoard_v26.1b.PcbDoc, Integrators.SchDoc, Power.SchDoc, Sergeant.PrjPcb]
2026-05-19 Initial BOMDOC work for Sergeant
    [BoardInterfaces.SchDoc]
2026-05-21 Schematic changes for V26C, Pre IO decision
    Still need to determine if the IO used for the negative voltage enable can be used, need to do some power supply sequencing analysis first.
    [ADC.SchDoc, BoardInterfaces.SchDoc, Integrators.SchDoc, Power.SchDoc, Sergeant.PrjPcb, TIA.SchDoc, soldier_TIA.SchDoc, top.SchDoc]
2026-05-26 PSU sequencing and AA filter ADC protection
    Rework Power supply sequencing to prevent power-on overvoltage event on ADC, add AA filters on needed inputs.
    [ADC.SchDoc, BoardInterfaces.SchDoc, Integrators.SchDoc, Power.SchDoc, TIA.SchDoc, soldier_ADC.SchDoc, soldier_Integrators.SchDoc, soldier_Power.SchDoc]
2026-05-28 Schematic Completion
    Proceeding to layout now for V26C. Fixed thermistor issue and reverted to decoder approach for IO expansion.
    [ADC.SchDoc, BoardInterfaces.SchDoc, Integrators.SchDoc, Power.SchDoc, Soldier.PrjPcb, TIA.SchDoc, soldier_ADC.SchDoc, soldier_BoardInterfaces.SchDoc]
2026-05-28 Sergeant Pre layout
    Minor changes per discussions:
    Add an independent supply for the TIA
    Some net labelling
    [ADC.SchDoc, Integrators.SchDoc, Power.SchDoc, TIA.SchDoc, top.SchDoc]
2026-05-29 Layout Day 1
    Some revisions to make this V26.4b, removed topside stacking header and vestigial bias switch for more breathing room in layout.
    [ADC.SchDoc, BoardInterfaces.SchDoc, TIA.SchDoc]
2026-05-29 Layout Day 2
    Improve topside floorplanning on Sergeant, almost complete non-plane routing.
    [ADC.SchDoc, ALTAIR_PD_Sergeant_V26.3b.PcbDoc]
2026-06-02 Sergeant all routing pre zones
    [ALTAIR_PD_Sergeant_V26.3b.PcbDoc, Integrators.SchDoc]
2026-06-03 Layout Day 3
    All zones and guarding finished. Only silkscreen and DRC remaining
    [ALTAIR_PD_Sergeant_V26.3b.PcbDoc]
2026-06-04 Sergeant DRC Pass
    Now on to soldier
    [ADC.SchDoc, ALTAIR_PD_Sergeant_V26.3b.PcbDoc, BoardInterfaces.SchDoc, Integrators.SchDoc, Power.SchDoc, Sergeant.PrjPcb, TIA.SchDoc, top.SchDoc]
2026-06-04 Soldier ERC pass
    [Power.SchDoc, soldier_ADC.SchDoc, soldier_BoardInterfaces.SchDoc, soldier_Power.SchDoc, soldier_TIA.SchDoc, soldier_top.SchDoc]
2026-06-04 Soldier Relay and critical signal path layout
    [ALTAIR_PD_Soldier_V26.1c.PcbDoc, soldier_TIA.SchDoc]
2026-06-04 Layout trick
    [ADC_SarSol.SchDoc, ALTAIR_PD_Sergeant_V26.2b_Reference.PcbDoc, ALTAIR_PD_Sergeant_V26.3b.PcbDoc, ALTAIR_PD_Soldier_V26.1c.PcbDoc, BoardInterfaces_SarSol.SchDoc, Integrators_SarSol.SchDoc, Power.SchDoc, Power_SarSol.SchDoc]
2026-06-05 Centerlining of board interconnects
    Eliminates mirroring shift that would require more layout
    [ALTAIR_PD_Sergeant_V26.3b.PcbDoc, soldier_Integrators.SchDoc]
2026-06-05 EOW commit
    [ALTAIR_PD_Sergeant_V26.3b.PcbDoc, BoardInterfaces.SchDoc, BoardInterfaces_SarSol.SchDoc, Integrators.SchDoc, Integrators_SarSol.SchDoc, TIA.SchDoc, TIA_SarSol.SchDoc, top.SchDoc]
2026-06-08 Soldier DRC Pass
    MVP at this point, just some refinements left
    [ALTAIR_PD_Sergeant_V26.3b.PcbDoc]
2026-06-09 Reverse Bias protection - Soldier
    [ALTAIR_PD_Sergeant_V26.3b.PcbDoc, BoardInterfaces_SarSol.SchDoc]
2026-06-09 Some cleanup I
    [ADC_SarSol.SchDoc, ALTAIR_PD_Sergeant_V26.3b.PcbDoc, ALTAIR_PD_Soldier_V26.4c.PcbDoc, BoardInterfaces.SchDoc, BoardInterfaces_SarSol.SchDoc, Integrators_SarSol.SchDoc, Power_SarSol.SchDoc, Sergeant.PrjPcb]
2026-06-09 Renaming cleanup
    [ADC.SchDoc, ADC_SarSol.SchDoc, ALTAIR_PD_Sergeant_V26.2b_Reference.PcbDoc, ALTAIR_PD_Sergeant_V26.3b.PcbDoc, ALTAIR_PD_Soldier_V26.1a.PcbDoc, ALTAIR_PD_Soldier_V26.1c.PcbDoc, ALTAIR_PD_Soldier_V26.4c.PcbDoc, BoardInterfaces.SchDoc]
2026-06-10 Schematic cleanup
    [ADC_SarSol.SchDoc, ALTAIR_PD_Sergeant_V26.4c.PcbDoc, ALTAIR_PD_Soldier_V26.4c.PcbDoc, BoardInterfaces.SchDoc, BoardInterfaces_SarSol.SchDoc, Integrators.SchDoc, Integrators_SarSol.SchDoc, Power.SchDoc]
2026-06-10 Filename and old documentation cleanup
    [ADC.SchDoc, ADC_Sergeant.SchDoc, ADC_Soldier.SchDoc, ALTAIR_PD_Sergeant_V26.2b_Reference.PcbDoc, ALTAIR_PD_Sergeant_V26.4c.PcbDoc, ALTAIR_PD_Soldier_V26.4c.PcbDoc, BoardInterfaces.SchDoc, BoardInterfaces_SarSol.SchDoc]
2026-07-20 Finalized V26C*
    V26C* represents the sum of all bodges and changes to get V26C operational. These include:
    - Addition of a 1k parallel resistor in the low gain path for high flux operation
    - Power supply sequencing fix to prevent strange oscillator
    - Removal of active low IO expander
    [ADC_Sergeant.SchDoc, ADC_Soldier.SchDoc, ALTAIR_PD_Soldier_V26.4c.PcbDoc, BoardInterfaces_Sergeant.SchDoc, BoardInterfaces_Soldier.SchDoc, DDC112_Prototypes.PrjPcb, Power_Sergeant.SchDoc, Power_Soldier.SchDoc]
2026-07-20 Add V26C Enclosures
    [FlightCover - Sergeant.stl, FlightCover - Soldier.stl, Skirt.stl, TestCover.stl, V26C_Enclosures.3mf]
2026-07-24 Some Updated Connector Models
2026-07-24 V26C Prime
    Changes from V26C Include:
    - Removal of active low decoder
    - Direct wiring of AVDD to negative rail enables to prevent oscillation
    - Removal of unused external temp sense connector
    - Removal of problematic end of life DF19 connector and replacement with unified power/data cable and header (commonly available samtec)
    - Direct wire for SGT/SOL addressing
    [ADC_Soldier.SchDoc, ALTAIR_PD_Sergeant_V26.4c.PcbDoc, ALTAIR_PD_Soldier_V26.4c.PcbDoc, BoardInterfaces_Sergeant.SchDoc, BoardInterfaces_Soldier.SchDoc, Sergeant.PrjPcb, Soldier.PrjPcb, TIA_Sergeant.SchDoc]
2026-07-27 Schematic level V26C'' "Squad" Board
    [ACF_INTEGRATOR.SchDoc, ADC_CH_A.SchDoc, ADC_CH_B.SchDoc, ALTAIR_PD_Sergeant_V26.2b_Reference.PcbDoc, ALTAIR_PD_Sergeant_V26.4c.PcbDoc, BIAS_IO.SchDoc, BoardInterfaces_Sergeant.SchDoc, IVC_INTEGRATOR.SchDoc]
2026-07-28 Schematic almost complete, draft floorplan
    Added RF shield, voltage monitoring, and H bridge drivers for latching relays
    [ACF_INTEGRATOR.SchDoc, ADC_CH_A.SchDoc, ADC_CH_B.SchDoc, ALTAIR_PD_Sergeant_V26.4c.PcbDoc, BIAS_IO.SchDoc, BoardInterfaces_Sergeant.SchDoc, POWER_POSITIVE.SchDoc, RFSHIELDS.PcbLib]
2026-08-04 Schematic updates
    [ACF_INTEGRATOR.SchDoc, ADC_CH_A.SchDoc, ADC_CH_B.SchDoc, ALTAIR_PD_Sergeant_V26.4c.PcbDoc, BIAS_IO.SchDoc, BoardInterfaces_Sergeant.SchDoc, IO_Pwr_Clock.SchDoc, IVC_INTEGRATOR.SchDoc]
2026-08-05 Schematic complete and layout progress
    [ACF_INTEGRATOR.SchDoc, ADC_CH_A.SchDoc, ADC_CH_B.SchDoc, ALTAIR_PD_Sergeant_V26.4c.PcbDoc, BIAS_IO.SchDoc, IO_Pwr_Clock.SchDoc, IVC_INTEGRATOR.SchDoc, Level_Shifter.SchDoc]
2026-08-06 Major layout progress
    [ACF_INTEGRATOR.SchDoc, ADC_CH_A.SchDoc, ADC_CH_B.SchDoc, ALTAIR_PD_Sergeant_V26.4c.PcbDoc, ALTAIR_PD_Squad_V26.5a.PcbDoc, BIAS_IO.SchDoc, IO_Pwr_Clock.SchDoc, IVC_INTEGRATOR.SchDoc]
2026-08-08 Local Routing topside complete
    [ACF_INTEGRATOR.SchDoc, ALTAIR_PD_Squad_V26.5a.PcbDoc, IVC_INTEGRATOR.SchDoc, TIA_SWITCHES.SchDoc]
2026-08-10 Layout Progression, small footprint fixes
    [ALTAIR_PD_Squad_V26.5a.PcbDoc, IO_Pwr_Clock.SchDoc, RFSHIELDS.PcbLib]
2026-08-11 Pre-guarding
    Zones and rules look good, altium built in guarding can be a bit buggy so pre-checkpointing
    [ALTAIR_PD_Sergeant_V26.4c.PcbDoc, ALTAIR_PD_Soldier_V26.4c.PcbDoc, ALTAIR_PD_Squad_V26.5a.PcbDoc, IO_Pwr_Clock.SchDoc, PositivePwr.SchDoc]
2026-08-11 Non-silkscreen DRC pass
    [ALTAIR_PD_Squad_V26.5a.PcbDoc]
2026-08-12 Reduce to 4layers
    [ALTAIR_PD_Squad_V26.5a.PcbDoc]
2026-08-12 DRC Pass
    [ALTAIR_PD_Squad_V26.5a.PcbDoc]
2026-08-12 As of Telecon, with some LCSC
    [ACF_INTEGRATOR.SchDoc, ADC_CH_A.SchDoc, ADC_CH_B.SchDoc, ALTAIR_PD_Squad_V26.5a.PcbDoc, IO_Pwr_Clock.SchDoc, NegativePwr.SchDoc, PositivePwr.SchDoc, Squad.PrjPcb]
2026-08-14 V26C'' "Squad" Complete
    Release to follow. DFM and silkscreen work mostly in this push, and some power zone work.
    [ADC_CH_A.SchDoc, ADC_CH_B.SchDoc, ALTAIR_PD_Squad_V26.5a.PcbDoc, ALTAIR_PD_Squad_V26.5a_cut.PcbDoc, BIAS_IO.SchDoc, IO_Pwr_Clock.SchDoc, NegativePwr.SchDoc, PositivePwr.SchDoc]
2026-09-18 V26D Schematic almost complete
    [ACF_INTEGRATOR.SchDoc, ADC.SchDoc, ADC_CH_A.SchDoc, ADC_CH_B.SchDoc, ALTAIR_PD_Squad_V26.5a.PcbDoc, BIAS_IO.SchDoc, DDC.SchDoc, DDC112_TestBoard_v26.1b.PcbDoc]
2026-09-18 Pre-layout schematic complete
    Subject to minor revisions still to accommodate layout, but foundationally will not change much beyond this point
    [ADC.SchDoc, ALTAIR_PD_Squad_V26.5a.PcbDoc, BIAS_IO.SchDoc, DDC.SchDoc, IO_Pwr_Clock.SchDoc, PositivePwr.SchDoc, Power.SchDoc, Squad.PrjPcb]
2026-09-18 Tiny EOD push
    [ALTAIR_PD_Squad_V26.5a.PcbDoc, Squad.PrjPcb, TIA_Soldier.SchDoc]
2026-09-22 Schematic complete, Layout Day 1
    [ALTAIR_PD_Squad_V26.5a.PcbDoc, BIAS_IO.SchDoc, DDC.SchDoc, TIA_SWITCHES.SchDoc, top_Squad.SchDoc]
2026-09-23 Layout functionally complete, DRC and ERC passing
    Remaining is silkscreen work and some zone fill improvements
    [ALTAIR_PD_Squad_V26.5a.PcbDoc, BIAS_IO.SchDoc, DDC.SchDoc, IO_Pwr_Clock.SchDoc, Power.SchDoc, RFSHIELDS.PcbLib, Squad.PrjPcb, TIA_SWITCHES.SchDoc]
2026-09-24 Layout Complete
    [ALTAIR_PD_Squad_V26.5a.PcbDoc, BIAS_IO.SchDoc, DDC.SchDoc, IO_Pwr_Clock.SchDoc, TIA_SWITCHES.SchDoc, top_Squad.SchDoc]
2026-09-28 BOM Modifications for JLC
    [ADC.SchDoc, ALTAIR_PD_Squad_V26.5a.PcbDoc, BIAS_IO.SchDoc, DDC.SchDoc, IO_Pwr_Clock.SchDoc, Power.SchDoc]
2026-09-30 Final prerelease changes
    Mostly BOM work and some little things around the schematic and PCB. Added JLC domestic alternatives for some unsourceable parts.
    [ADC.SchDoc, ALTAIR_PD_Squad_V26.5a.PcbDoc, ALTAIR_PD_Squad_V26.5a_cut.PcbDoc, BIAS_IO.SchDoc, DDC.SchDoc, IO_Pwr_Clock.SchDoc, Power.SchDoc, Squad.PrjPcb]
2026-09-30 Tiny color change
    [top_Squad.SchDoc]
2026-10-29 V26.5b revisions
    This fixes two little problems observed with the first production V26D boards:
    - Vias in thermal pad for the negative supply resulted in thieving and disconnected ground, causing IC to get fried. Moved and reduced those vias.
    - Ref out needs to be tied to REFCOM for full 0-5V measurement
